3Dator/3dator_mods/3Dator Belt Bed/README.md

# 3dator_Belt_Bed
This is our Prototype Belt Bed. It works by printing on a conveyor belt.
The Motor is connected in parallel with the Heatbed and moves by reversing the current with an H Bridge.

This Thing is still in development, because it is still tricky to assemble.
It fits our Printbed as an easy swap in replacement.

http://wiki.3dator.com

# what to do with the files
* Feel free to print the files for your 3Dator or even some other fdm machine.
* Modify the files to fit your needs, keep in mind to share what you've done with others and don't forget to mention us ;)
* You just stumbled across this and only want to buy a full kit? Visit our shop: http://3dator.com/shop
* Any tipps or suggestions? Make shure to send us a message!
