3Dator/3dator_mods/alternative Fantubes/README.md

# 3dator mod alternative Fantubes	
Here you can find the source Files of the alternative Fantubes for mounting different Hotends in your 3Dator.  
for more information about us visit:

http://3dator.com

http://wiki.3dator.com

### supported Hotends ###
* E3D v6
* E3D Volcano
* Merlin Hotend
