3Dator/3dator_mods/y_adapter/README.md

# 3dator mod y adapter
With this adapter you can print two colors with one nozzle.

for more information about us visit:

http://3dator.com

http://wiki.3dator.com

# how to use
* print the adapter and build it into your printer (you will need a second extruder)
* download the latest 3dator firmware and open the file Marlin.ino with Arduino IDE
* Change the definition of DATOR_DUAL to 2
* upload the firmware onto your printer
* enjoy printing with two materials
