3Dator/3dator_mods/pen_holder/assembly.stp

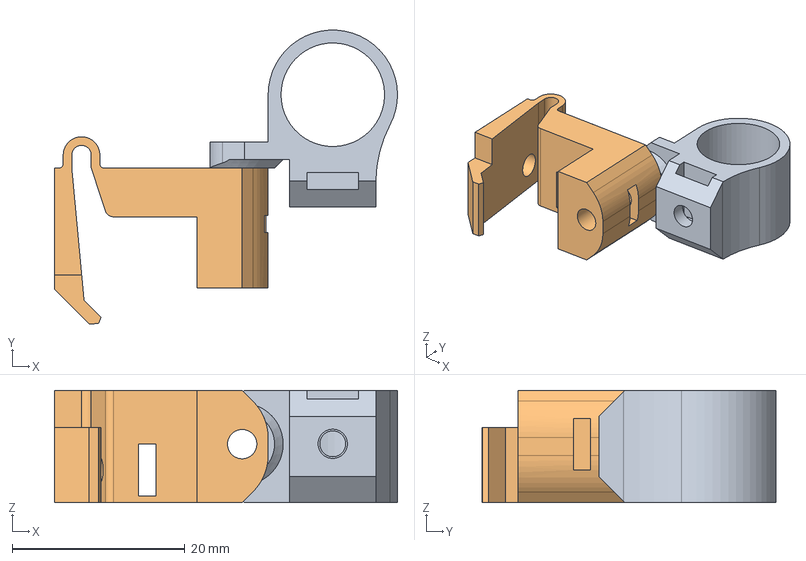
[picture p1: CAD file, 2017-06-25]
pen_holder/assembly.stp
39.8 x 34.1 x 13.0 mm
pen_holder
attachment
