3Dator/3dator_mods/alternative Fantubes/Dyze design coolingtube/cooling_tube_dyze.stp

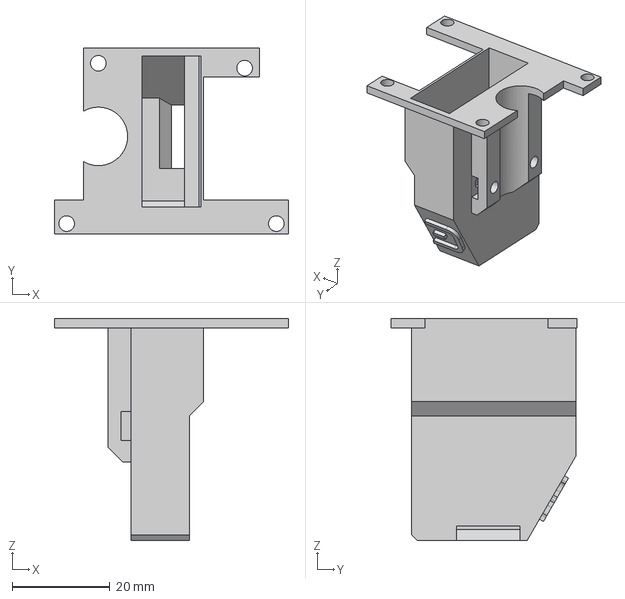
[picture p3: CAD file, 2017-04-26]
alternative Fantubes/Dyze design coolingtube/cooling_tube_dyze.stp
48.0 x 38.1 x 45.6 mm
