3Dator/3dator_mods/alternative Fantubes/E3D v6 coolingtube/E3D_v6 coolingtube.stp

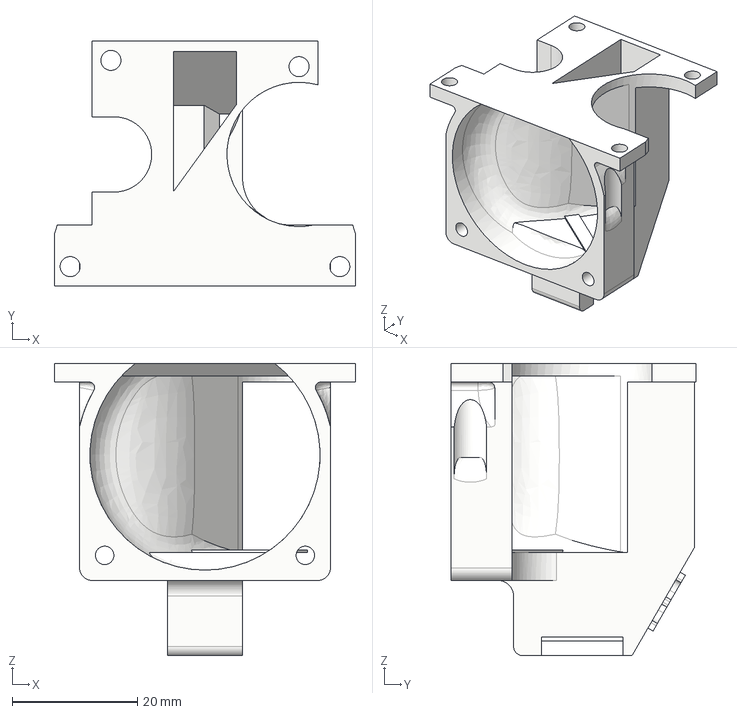
[picture p4: CAD file, 2016-08-03]
alternative Fantubes/E3D v6 coolingtube/E3D_v6 coolingtube.stp
48.0 x 39.1 x 46.6 mm
