3Dator/3dator_mods/alternative Fantubes/E3D Volcano coolingtube/e3D Volcano coolingtube.step

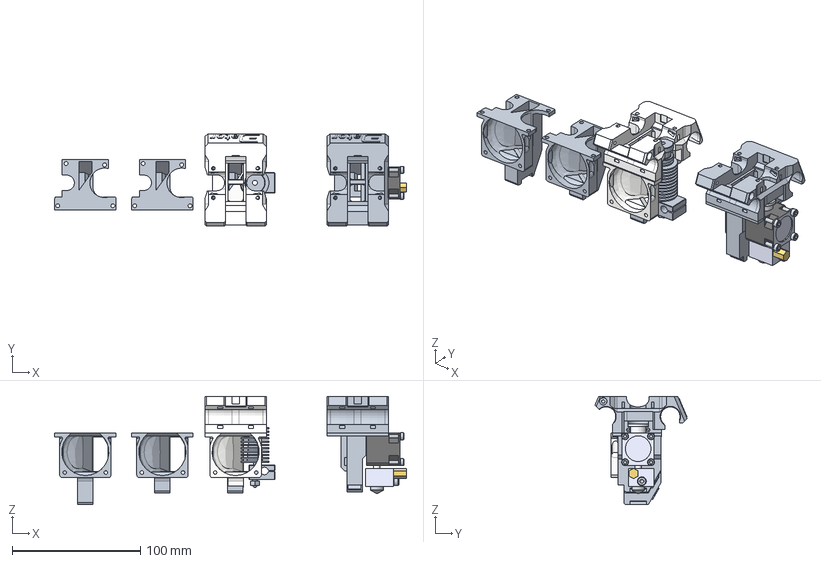
[picture p5: CAD file, 2016-08-03]
alternative Fantubes/E3D Volcano coolingtube/e3D Volcano coolingtube.step
274.0 x 71.9 x 84.3 mm
cooling_tube_dual
E3D_V6
e3D_volcano
Printhead v18
Printhead v18_1
Cyclops v2
DyzEND-Solid-160215 v1
dyze_end_fantube
