3Dator/3dator_mods/bl_touch_bed_probe/BLTouch-Halter.stl

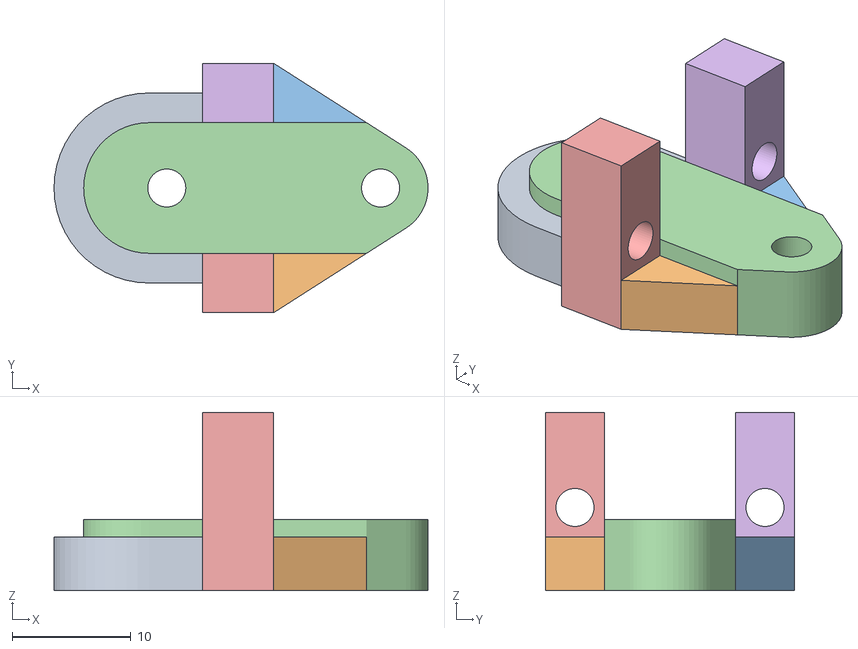
[picture p6: CAD file, 2017-04-26]
bl_touch_bed_probe/BLTouch-Halter.stl
31.5 x 21.0 x 15.0
ACIS Solid_51433
ACIS Solid_52651
ACIS Solid_52852
ACIS Solid_53080
ACIS Solid_54651
ACIS Solid_55181
