3Dator/3dator_mods/enclosure/top.dxf

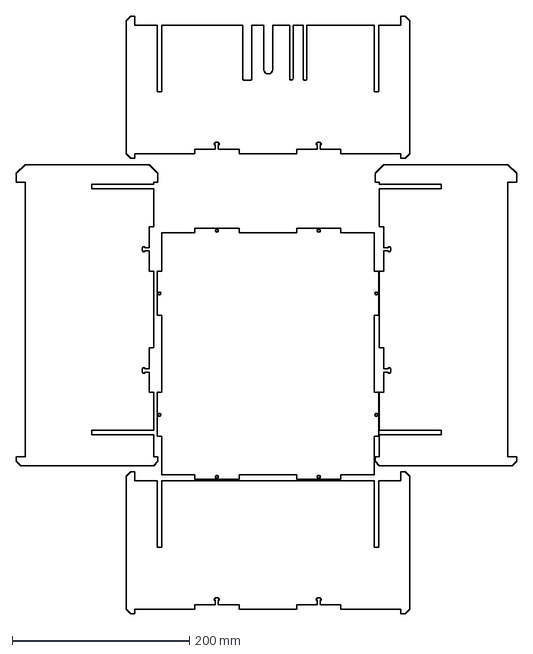
[picture p7: CAD file, 2017-07-26]
enclosure/top.dxf
565.0 x 674.2 mm
