3Dator/3dator_mods/filament_switch/filament_sensor.step

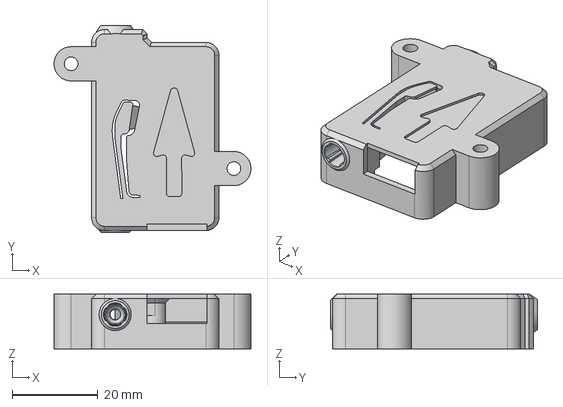
[picture p8: CAD file, 2017-07-26]
filament_switch/filament_sensor.step
46.1 x 48.5 x 12.8 mm
