3Dator/3dator_mods/pcb_plotter_scratcher/rod_pusher.stl

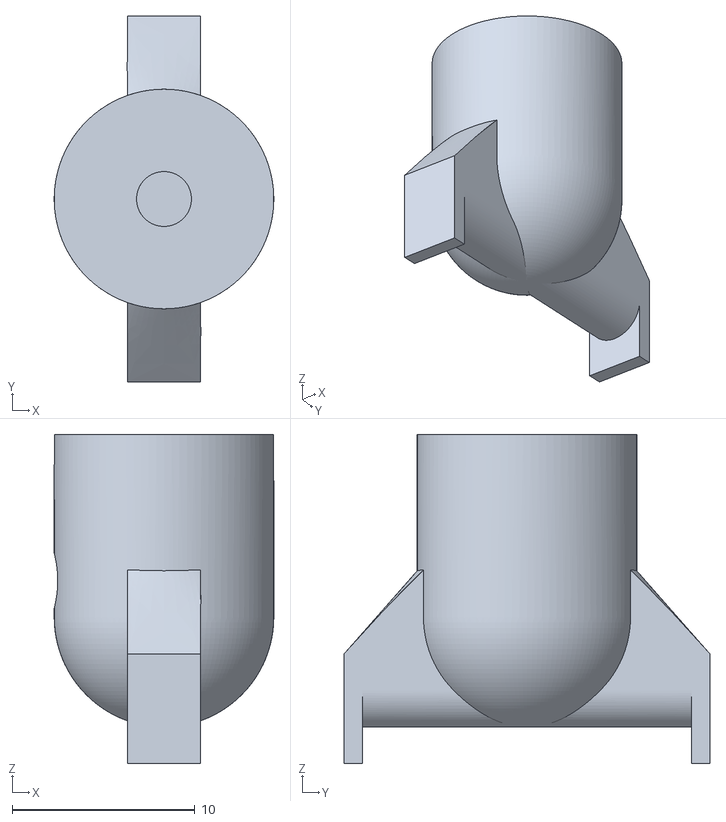
[picture p9: CAD file, 2017-04-26]
pcb_plotter_scratcher/rod_pusher.stl
12.0 x 20.0 x 18.0
