3Dator/3dator_mods/pen_holder/attachment.stl

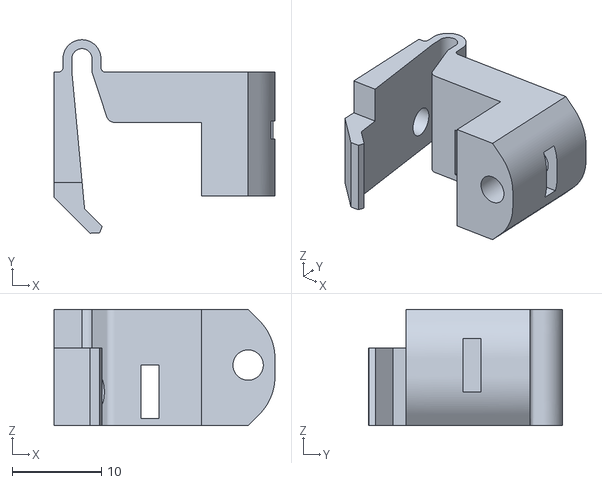
[picture p10: CAD file, 2017-06-25]
pen_holder/attachment.stl
24.8 x 21.7 x 13.0
