3Dator/3dator_mods/raspberry_pi_cam_holder/PiCam_holder.step

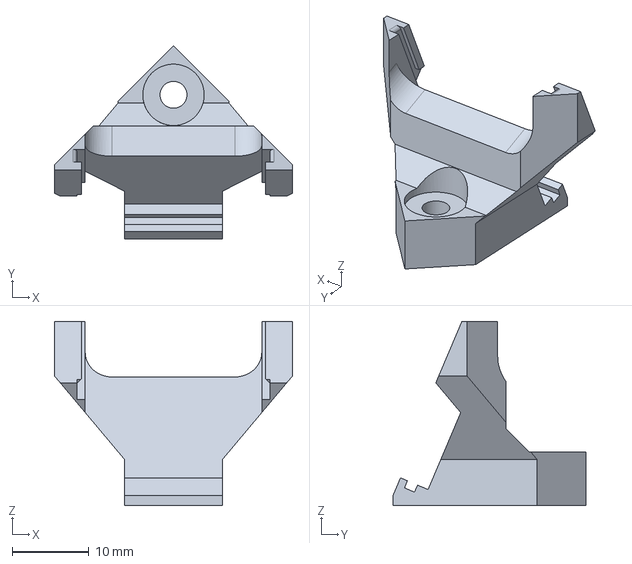
[picture p11: CAD file, 2017-04-26]
raspberry_pi_cam_holder/PiCam_holder.step
31.0 x 25.1 x 24.0 mm
