3Dator/3dator_mods/rubber_foot/rubber_foot.stl

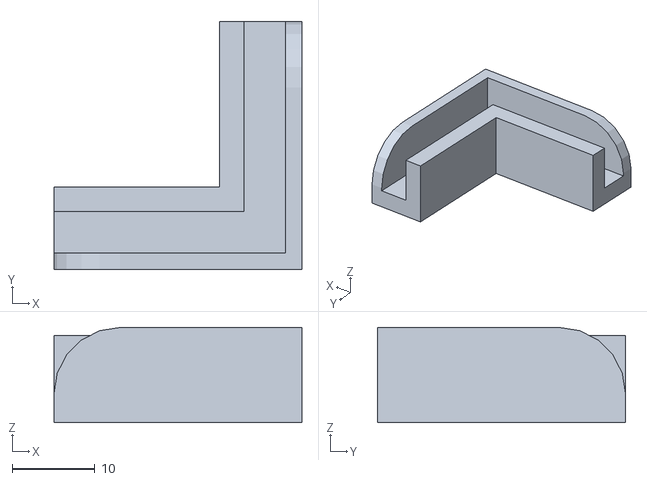
[picture p12: CAD file, 2017-04-26]
rubber_foot/rubber_foot.stl
30.0 x 30.0 x 11.5
