3Dator/3dator_mods/y_adapter/3dator_y_piece.step

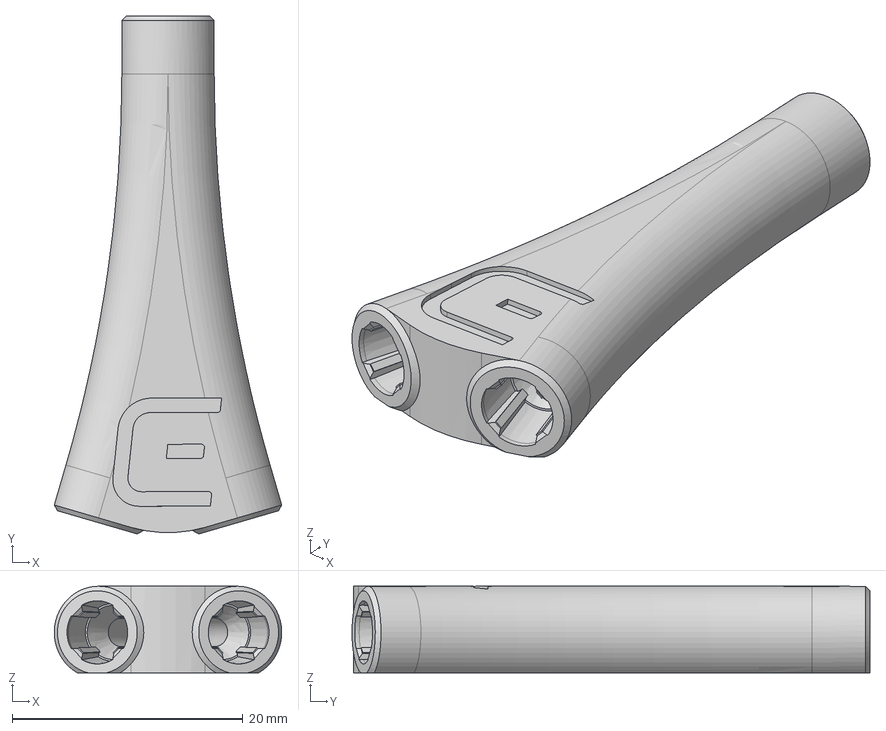
[picture p13: CAD file, 2016-07-22]
y_adapter/3dator_y_piece.step
19.7 x 44.8 x 7.50 mm
