3Dator/3dator_mods/enclosure/door.dxf

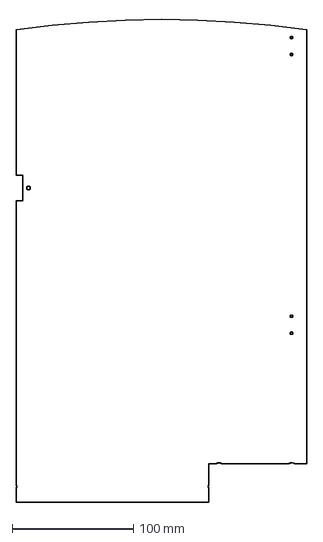
[picture p14: CAD file, 2017-06-25]
enclosure/door.dxf
240.0 x 401.2 mm
