3Dator/3dator_mods/pcb_plotter_scratcher/rod_tube.stl

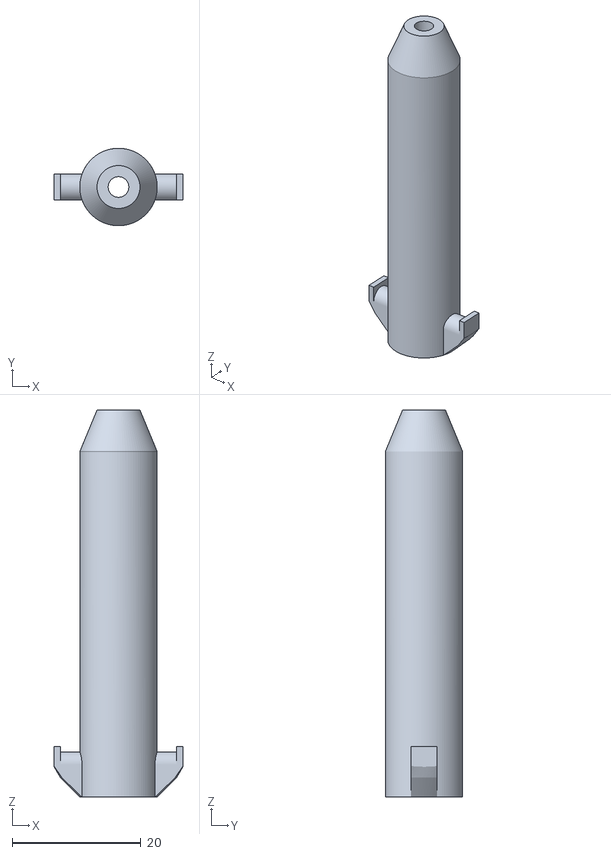
[picture p15: CAD file, 2017-04-26]
pcb_plotter_scratcher/rod_tube.stl
20.0 x 12.0 x 60.0
