3Dator/3dator_mods/pen_holder/3dator_draw_sample_file.stl

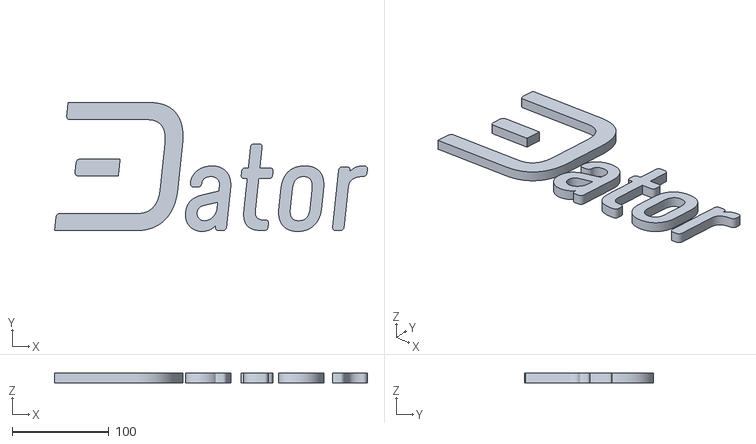
[picture p16: CAD file, 2017-06-25]
pen_holder/3dator_draw_sample_file.stl
323.9 x 133.5 x 10.0
