3Dator/3dator_mods/enclosure/top_lock.stp

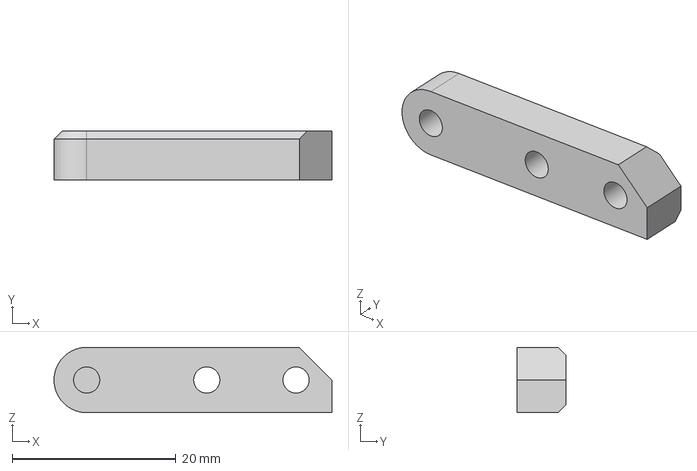
[picture p17: CAD file, 2017-05-10]
enclosure/top_lock.stp
34.0 x 6.00 x 8.00 mm
