3Dator/3dator_mods/enclosure/door_handle.stp

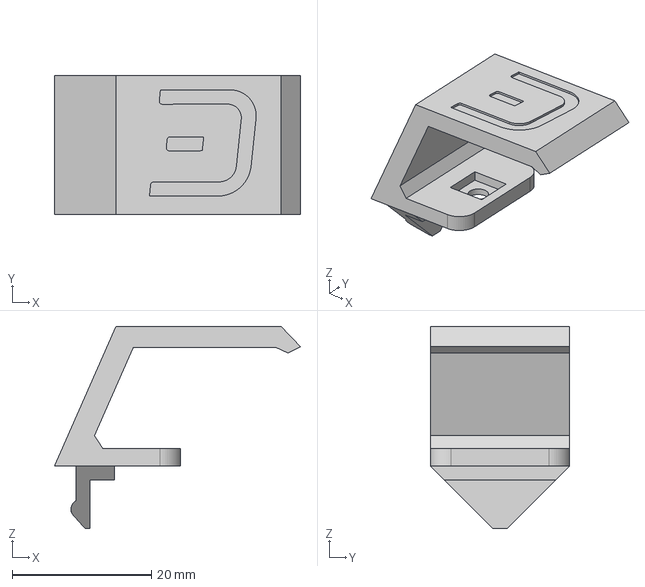
[picture p18: CAD file, 2017-05-10]
enclosure/door_handle.stp
35.3 x 20.0 x 29.0 mm
