3Dator/3dator_mods/pen_holder/pen_holder.stl

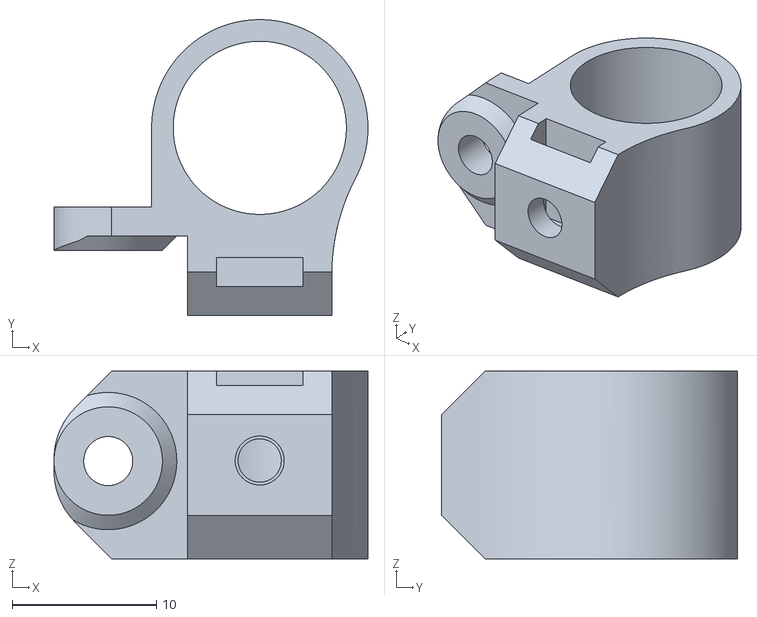
[picture p19: CAD file, 2017-06-25]
pen_holder/pen_holder.stl
21.8 x 20.5 x 13.0
