3Dator/3dator_mods/enclosure/door_mount.stp

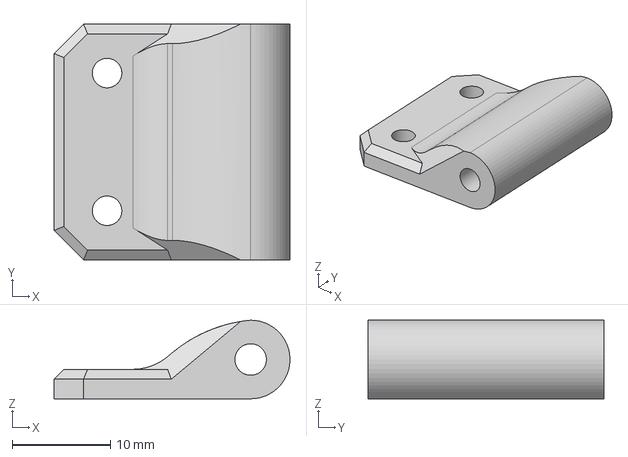
[picture p20: CAD file, 2017-05-10]
enclosure/door_mount.stp
24.0 x 24.0 x 8.00 mm
