3Dator/3dator_mods/enclosure/front_mount.stp

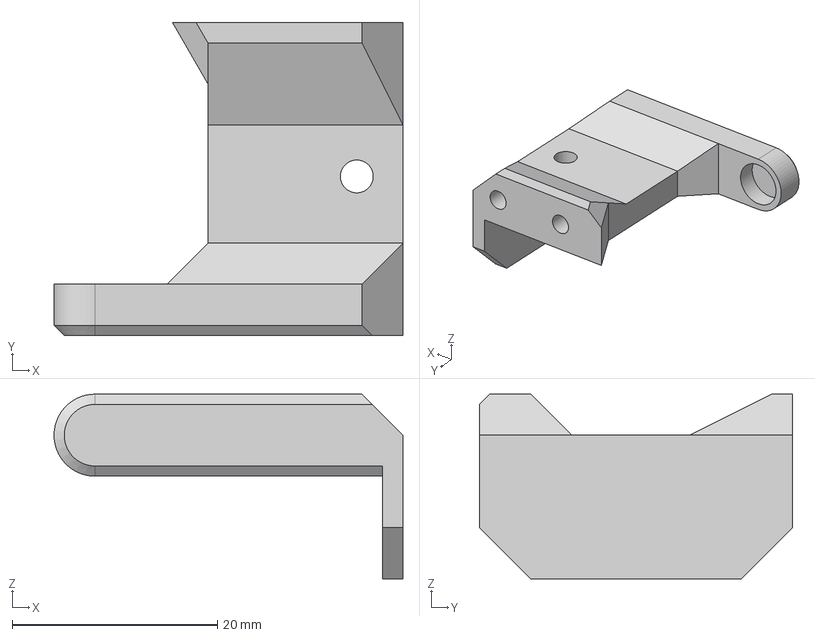
[picture p21: CAD file, 2017-05-10]
enclosure/front_mount.stp
34.0 x 30.5 x 18.0 mm
