3Dator/3dator_mods/(list of files, cad)

Other CAD files:
alternative Fantubes/Dyze design coolingtube/cooling_tube_dyze.stl
alternative Fantubes/E3D Volcano coolingtube/e3D Volcano coolingtube.stl
alternative Fantubes/E3D v6 coolingtube/E3D_v6 coolingtube.stl
enclosure/door_handle.stl
enclosure/door_mount.stl
enclosure/front_mount.stl
enclosure/top_lock.stl
filament_switch/filament_sensor.stl
raspberry_pi_cam_holder/PiCam_holder.stl
y_adapter/3dator_y_piece.stl
