3Dator/3dator_mods/(commit log)

2016-08-03 added coolingtubes for E3D v6 and Volcano
    [E3D_v6 coolingtube.stl, E3D_v6 coolingtube.stp, e3D Volcano coolingtube.step, e3D Volcano coolingtube.stl]
2017-04-26 added more mods and upgrades
    [cooling_tube_dyze.stl, cooling_tube_dyze.stp]
2017-04-26 added more mods and upgrades that were only uploaded to thingiverse
    [PiCam_holder.step, PiCam_holder.stl, rod_pusher.stl, rod_tube.stl, rubber_foot.stl]
2017-04-26 added bl touch holder
    [BLTouch-Halter.stl]
2017-05-03 added filament sensor
    [filament_sensor.step, filament_sensor.stl]
2017-05-10 added first enclosure files
    [door.dxf, door_handle.stl, door_handle.stp, door_mount.stl, door_mount.stp, front_mount.stl, front_mount.stp, top_lock.stl]
2017-05-26 made door a very bit shorter
    [door.dxf, top.dxf]
2017-06-25 added pen holder
    [3dator_draw_sample_file.stl, assembly.stp, attachment.stl, door.dxf, pen_holder.stl]
2017-07-04 updated filament switch
    [filament_sensor.stl]
2017-07-12 Added our Belt Bed Step Files
    [3Dator Belt Bed.step]
2017-07-26 fixed but in enclosure top
    [door.dxf, door_handle.stl, door_handle.stp, door_mount.stl, door_mount.stp, filament_sensor.step, front_mount.stl, front_mount.stp]
